jimmyw/energymeter/energymeter.jpg

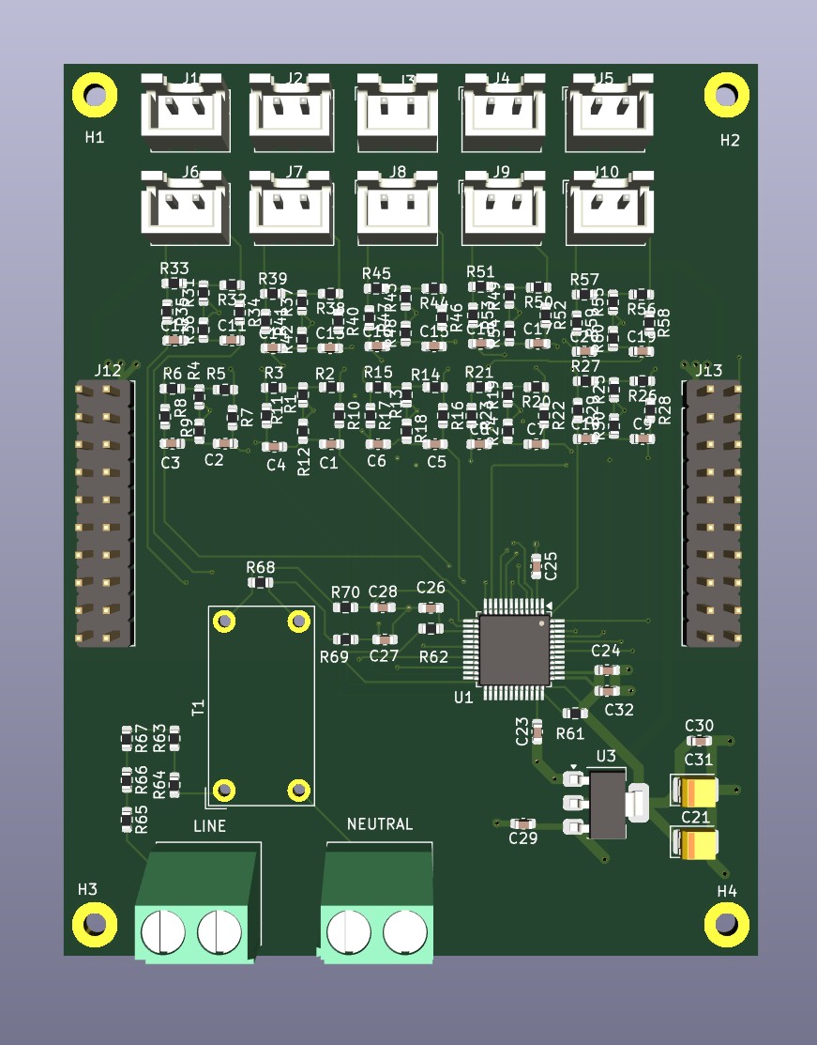
energymeter.jpg
