jimmyw/energymeter/stl/Controller.stl

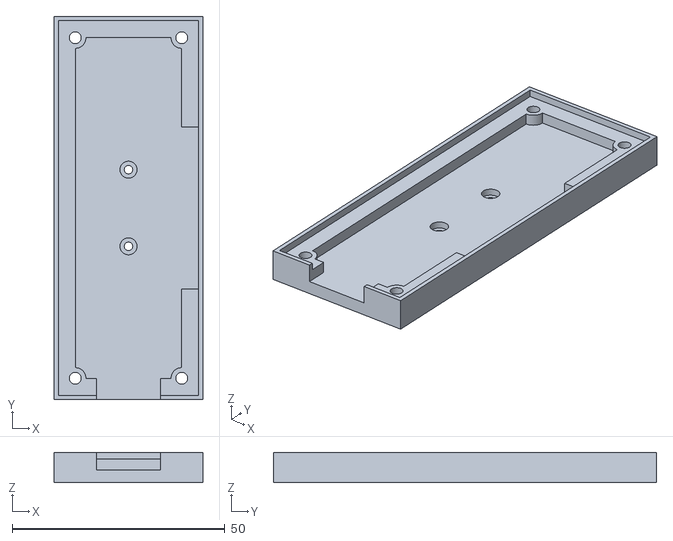
[picture p2: CAD file, 2025-09-19]
stl/Controller.stl
35.0 x 90.0 x 7.10
