jimmyw/energymeter/stl/CoverSmall-small.stl

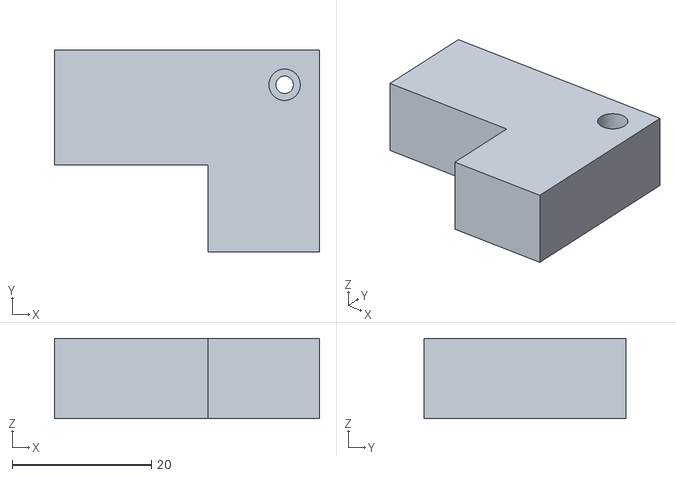
[picture p3: CAD file, 2025-09-19]
stl/CoverSmall-small.stl
38.0 x 29.0 x 11.5
