jimmyw/energymeter/stl/din_rail_mount_G9.stl

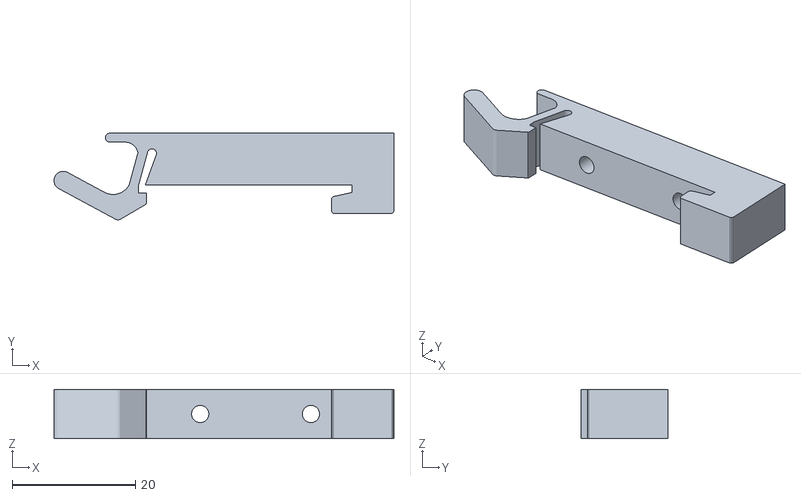
[picture p4: CAD file, 2025-09-19]
stl/din_rail_mount_G9.stl
55.3 x 14.1 x 8.00
