jimmyw/energymeter/stl/EnergyMeter.stl

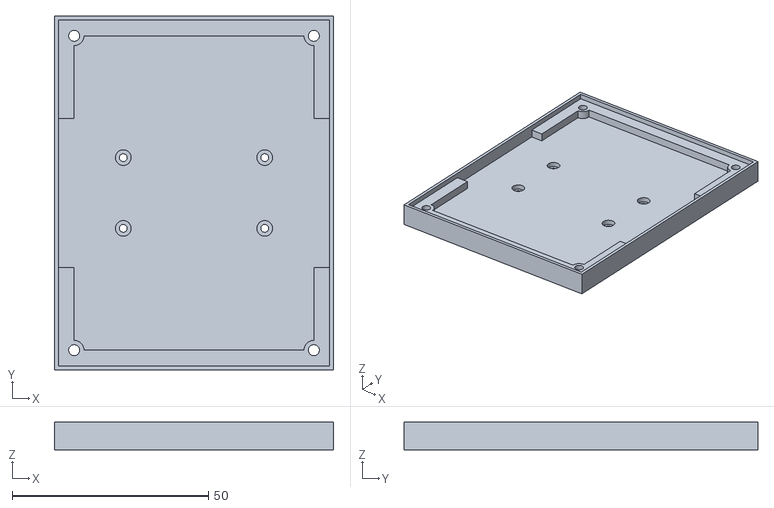
[picture p5: CAD file, 2025-09-19]
stl/EnergyMeter.stl
71.0 x 90.0 x 7.10
