jimmyw/energymeter/stl/controller-lid.stl

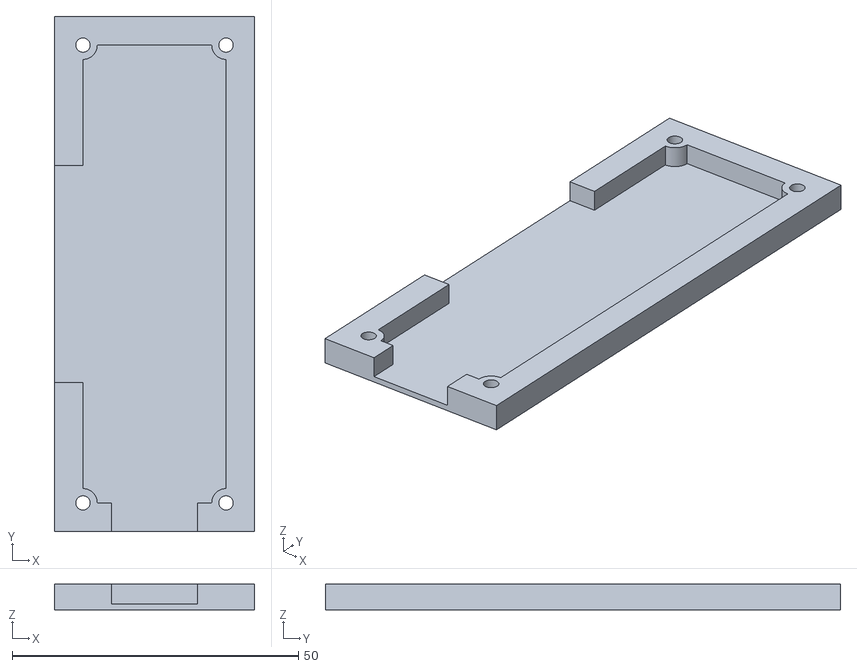
[picture p6: CAD file, 2025-09-19]
stl/controller-lid.stl
35.0 x 90.0 x 4.50
