jimmyw/energymeter/energymeter.kicad_pcb

## KiCad design energymeter.kicad_pcb (2024-08-17)

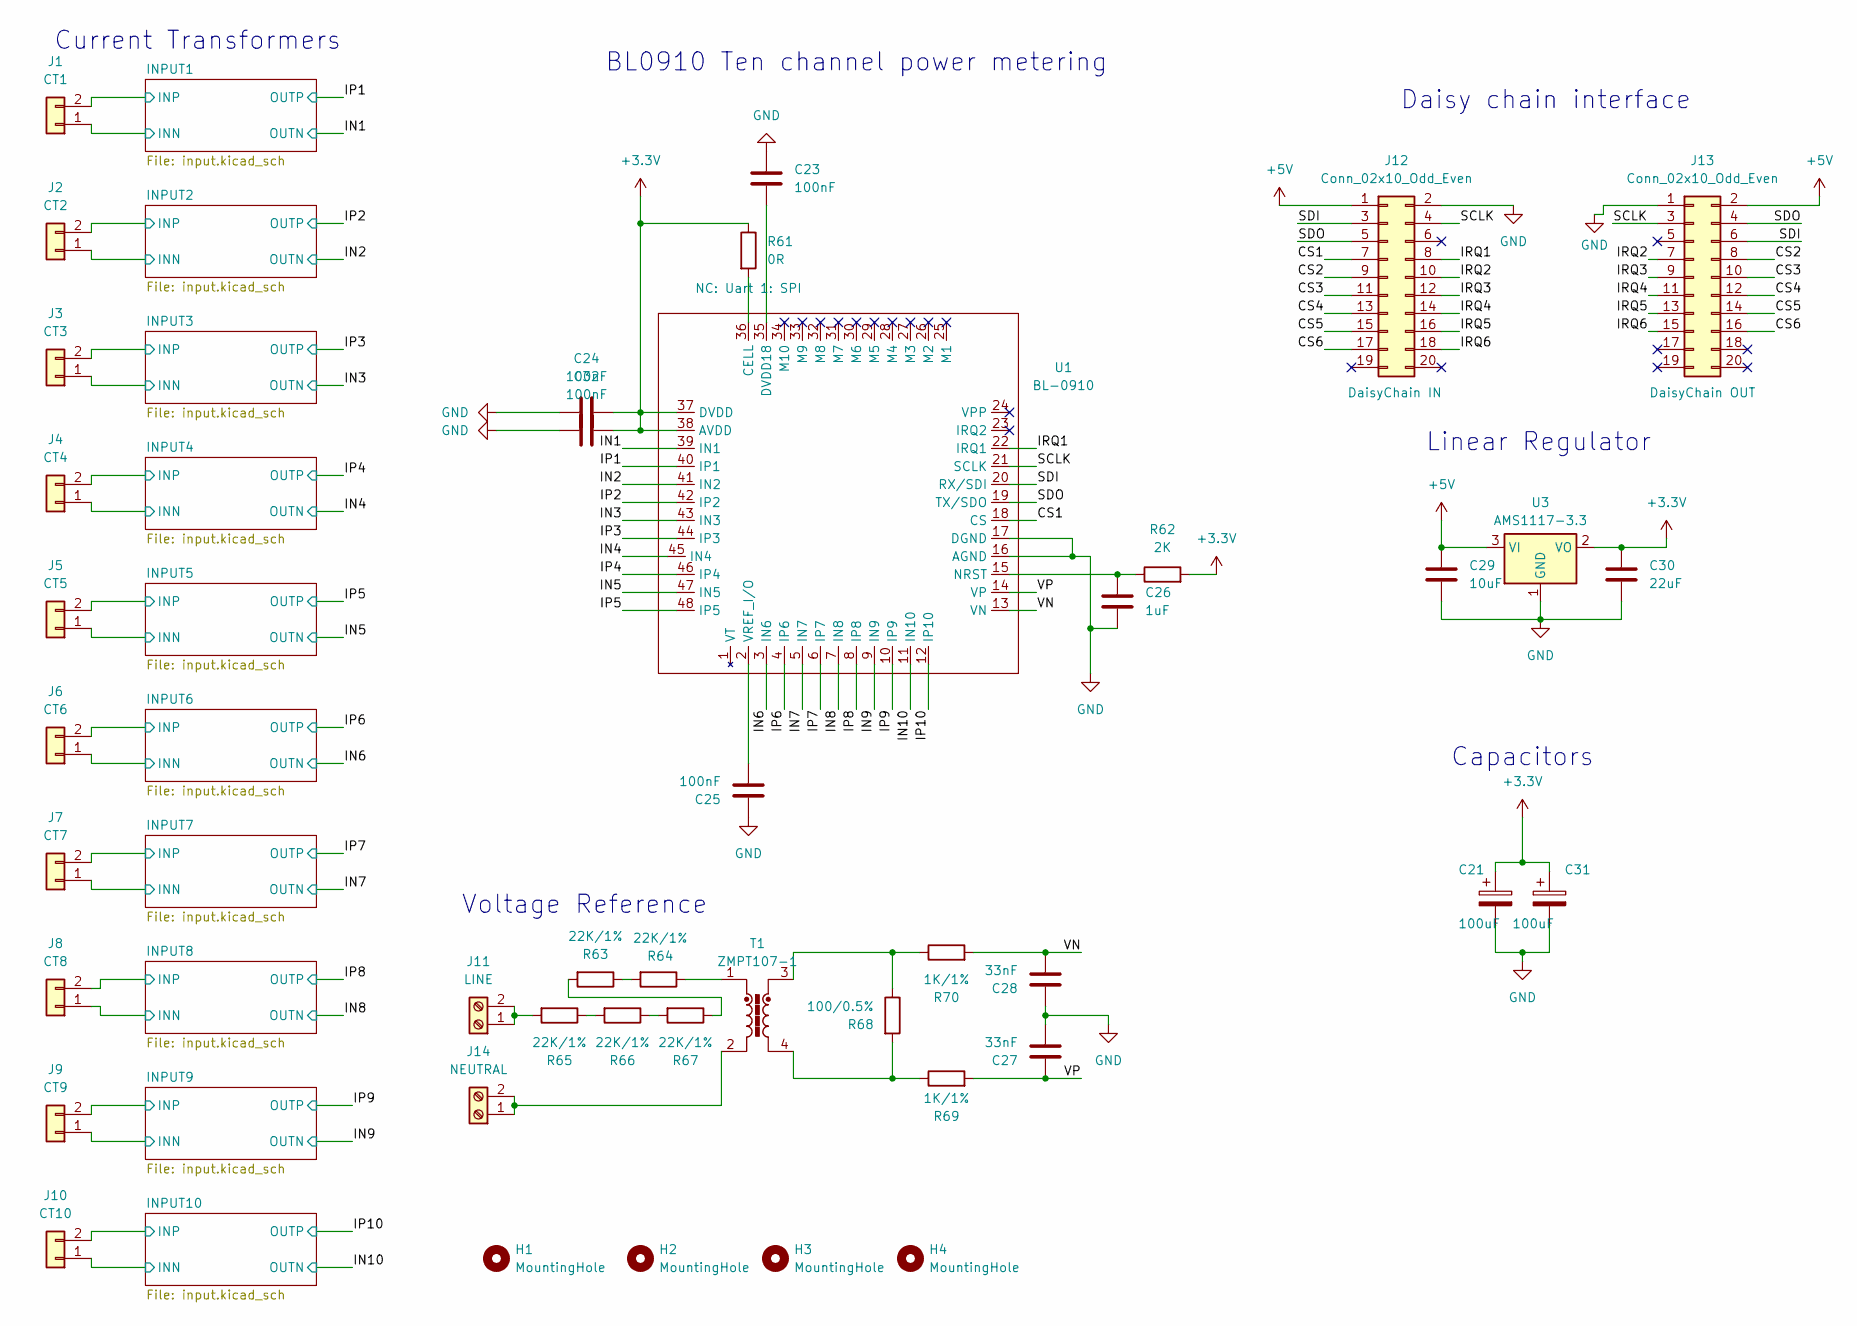
[picture p18: schematic energymeter.kicad_sch]

Parts:
C21, C31: 100uF; CP_EIA-3528-21_Kemet-B; LCSC C16133
C23, C24, C25, C32: 100nF; C_0603_1608Metric; LCSC C14858
C26: 1uF; C_0603_1608Metric; LCSC C15849
C27, C28: 33nF; C_0603_1608Metric; LCSC C21117
C29: 10uF; C_0603_1608Metric; LCSC C14858
C30: 22uF; C_0603_1608Metric; LCSC C59461
H1, H2, H3, H4: MountingHole; MountingHole_2.2mm_M2_Pad
J1: CT1; JST_XH_B2B-XH-A_1x02_P2.50mm_Vertical; LCSC C265283
J2: CT2; JST_XH_B2B-XH-A_1x02_P2.50mm_Vertical; LCSC C265283
J3: CT3; JST_XH_B2B-XH-A_1x02_P2.50mm_Vertical; LCSC C265283
J4: CT4; JST_XH_B2B-XH-A_1x02_P2.50mm_Vertical; LCSC C265283
J5: CT5; JST_XH_B2B-XH-A_1x02_P2.50mm_Vertical; LCSC C265283
J6: CT6; JST_XH_B2B-XH-A_1x02_P2.50mm_Vertical; LCSC C265283
J7: CT7; JST_XH_B2B-XH-A_1x02_P2.50mm_Vertical; LCSC C265283
J8: CT8; JST_XH_B2B-XH-A_1x02_P2.50mm_Vertical; LCSC C265283
J9: CT9; JST_XH_B2B-XH-A_1x02_P2.50mm_Vertical; LCSC C265283
J10: CT10; JST_XH_B2B-XH-A_1x02_P2.50mm_Vertical; LCSC C265283
J11: LINE; TerminalBlock_Phoenix_MKDS-1,5-2_1x02_P5.00mm_Horizontal; LCSC C128027
J12: Conn_02x10_Odd_Even; PinHeader_2x10_P2.54mm_Vertical; LCSC C5454488
J13: Conn_02x10_Odd_Even; PinHeader_2x10_P2.54mm_Vertical; LCSC C239361
J14: NEUTRAL; TerminalBlock_Phoenix_MKDS-1,5-2_1x02_P5.00mm_Horizontal; LCSC C128027
R61: 0R; R_0603_1608Metric; LCSC C21189
R62: 2K; R_0603_1608Metric; LCSC C22975
R63, R64, R65, R66, R67: 22K/1%; R_0603_1608Metric; LCSC C31850
R68: 100/0.5%; R_0603_1608Metric; LCSC C22775
R69, R70: 1K/1%; R_0603_1608Metric; LCSC C21190
T1: ZMPT107-1; LCSC C125191
U1: BL-0910; LQFP-48_7x7mm_P0.5mm; LCSC C2841006
U3: AMS1117-3.3; SOT-223-3_TabPin2; LCSC C6186

Connections:
+3.3V: C21.1, C24.2, C30.1, C31.1, C32.2, R61.1, R62.2, U1.37 (DVDD), U1.38 (AVDD), U3.2 (VO)
+5V: C29.1, J12.1, J13.2, U3.3 (VI)
/CS1: J12.7, U1.18 (CS)
/CS2: J12.9, J13.8
/CS3: J12.11, J13.10
/CS4: J12.13, J13.12
/CS5: J12.15, J13.14
/CS6: J12.17, J13.16
/IN1: U1.39 (IN1); also elsewhere on the board
/IN2: U1.41 (IN2); also elsewhere on the board
/IN3: U1.43 (IN3); also elsewhere on the board
/IN4: U1.45 (IN4); also elsewhere on the board
/IN5: U1.47 (IN5); also elsewhere on the board
/IN6: U1.3 (IN6); also elsewhere on the board
/IN7: U1.5 (IN7); also elsewhere on the board
/IN8: U1.7 (IN8); also elsewhere on the board
/IN9: U1.9 (IN9); also elsewhere on the board
/IN10: U1.11 (IN10); also elsewhere on the board
/INPUT1/INN: J1.1; also elsewhere on the board
/INPUT1/INP: J1.2; also elsewhere on the board
/INPUT2/INN: J2.1; also elsewhere on the board
/INPUT2/INP: J2.2; also elsewhere on the board
/INPUT3/INN: J3.1; also elsewhere on the board
/INPUT3/INP: J3.2; also elsewhere on the board
/INPUT4/INN: J4.1; also elsewhere on the board
/INPUT4/INP: J4.2; also elsewhere on the board
/INPUT5/INN: J5.1; also elsewhere on the board
/INPUT5/INP: J5.2; also elsewhere on the board
/INPUT6/INN: J6.1; also elsewhere on the board
/INPUT6/INP: J6.2; also elsewhere on the board
/INPUT7/INN: J7.1; also elsewhere on the board
/INPUT7/INP: J7.2; also elsewhere on the board
/INPUT8/INN: J8.1; also elsewhere on the board
/INPUT8/INP: J8.2; also elsewhere on the board
/INPUT9/INN: J9.1; also elsewhere on the board
/INPUT9/INP: J9.2; also elsewhere on the board
/INPUT10/INN: J10.1; also elsewhere on the board
/INPUT10/INP: J10.2; also elsewhere on the board
/IP1: U1.40 (IP1); also elsewhere on the board
/IP2: U1.42 (IP2); also elsewhere on the board
/IP3: U1.44 (IP3); also elsewhere on the board
/IP4: U1.46 (IP4); also elsewhere on the board
/IP5: U1.48 (IP5); also elsewhere on the board
/IP6: U1.4 (IP6); also elsewhere on the board
/IP7: U1.6 (IP7); also elsewhere on the board
/IP8: U1.8 (IP8); also elsewhere on the board
/IP9: U1.10 (IP9); also elsewhere on the board
/IP10: U1.12 (IP10); also elsewhere on the board
/IRQ1: J12.8, U1.22 (IRQ1)
/IRQ2: J12.10, J13.7
/IRQ3: J12.12, J13.9
/IRQ4: J12.14, J13.11
/IRQ5: J12.16, J13.13
/IRQ6: J12.18, J13.15
/SCLK: J12.4, J13.3, U1.21 (SCLK)
/SDI: J12.3, J13.6, U1.20 (RX/SDI)
/SDO: J12.5, J13.4, U1.19 (TX/SDO)
/VN: C28.2, R70.2, U1.13 (VN)
/VP: C27.1, R69.2, U1.14 (VP)
GND: C21.2, C23.1, C24.1, C25.1, C26.2, C27.2, C28.1, C29.2, C30.2, C31.2, C32.1, J12.2, J13.1, U1.16 (AGND), U1.17 (DGND), U3.1 (GND); also elsewhere on the board
unnamed: J11.1, J11.2, R65.2
unnamed: J14.1, J14.2, T1.2
unnamed: R63.1, R64.2
unnamed: R63.2, R67.1
unnamed: R64.1, T1.1
unnamed: R65.1, R66.2
unnamed: R66.1, R67.2
unnamed: R68.1, R70.1, T1.3
unnamed: R68.2, R69.1, T1.4
unnamed: R61.2, U1.36 (CELL)
unnamed: C23.2, U1.35 (DVDD18)
unnamed: C26.1, R62.1, U1.15 (NRST)
unnamed: C25.2, U1.2 (VREF_I/O)

Notes on the sheet:
Voltage Reference
Capacitors
Daisy chain interface
Linear Regulator
Current Transformers
BL0910 Ten channel power metering

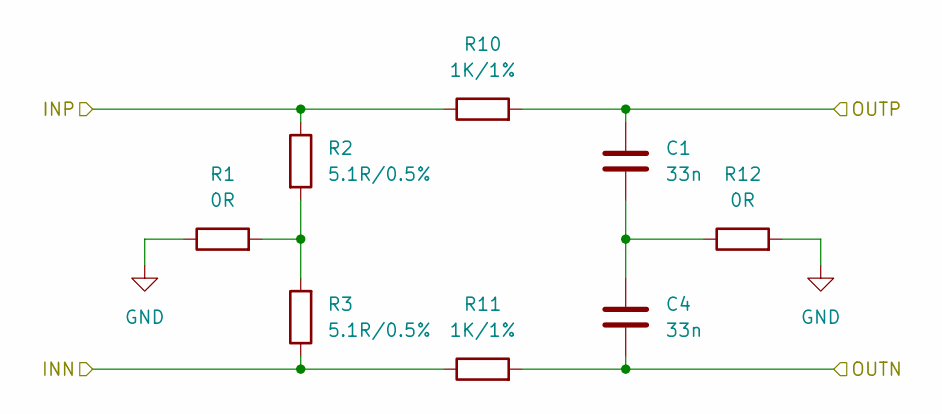
[picture p19: schematic input.kicad_sch]

Parts:
C1, C4: 33n; C_0603_1608Metric; LCSC C21117
R1, R12: 0R; R_0603_1608Metric; LCSC C21189
R2, R3: 5.1R/0.5%; R_0603_1608Metric; LCSC C657209
R10, R11: 1K/1%; R_0603_1608Metric; LCSC C21190

Connections:
/IN2: C4.1, R11.2; also elsewhere on the board
/INPUT2/INN: R3.1, R11.1; also elsewhere on the board
/INPUT2/INP: R2.1, R10.1; also elsewhere on the board
/IP2: C1.2, R10.2; also elsewhere on the board
GND: R1.1, R12.2; also elsewhere on the board
unnamed: C1.1, C4.2, R12.1
unnamed: R1.2, R2.2, R3.2

Parts of its further copies:
C2, C3, C5, C6, C7, C8, C9, C10, C11, C12, C13, C14, C15, C16, C17, C18, C19, C20: 33n; C_0603_1608Metric; LCSC C21117
R4, R9, R13, R18, R19, R24, R25, R30, R31, R36, R37, R42, R43, R48, R49, R54, R55, R60: 0R; R_0603_1608Metric; LCSC C21189
R5, R6, R14, R15, R20, R21, R26, R27, R32, R33, R38, R39, R44, R45, R50, R51, R56, R57: 5.1R/0.5%; R_0603_1608Metric; LCSC C657209
R7, R8, R16, R17, R22, R23, R28, R29, R34, R35, R40, R41, R46, R47, R52, R53, R58, R59: 1K/1%; R_0603_1608Metric; LCSC C21190

Connections of its further copies:
/IN1: C3.1, R8.2; also elsewhere on the board
/IN3: C6.1, R17.2; also elsewhere on the board
/IN4: C8.1, R23.2; also elsewhere on the board
/IN5: C10.1, R29.2; also elsewhere on the board
/IN6: C12.1, R35.2; also elsewhere on the board
/IN7: C14.1, R41.2; also elsewhere on the board
/IN8: C16.1, R47.2; also elsewhere on the board
/IN9: C18.1, R53.2; also elsewhere on the board
/IN10: C20.1, R59.2; also elsewhere on the board
/INPUT1/INN: R6.1, R8.1; also elsewhere on the board
/INPUT1/INP: R5.1, R7.1; also elsewhere on the board
/INPUT3/INN: R15.1, R17.1; also elsewhere on the board
/INPUT3/INP: R14.1, R16.1; also elsewhere on the board
/INPUT4/INN: R21.1, R23.1; also elsewhere on the board
/INPUT4/INP: R20.1, R22.1; also elsewhere on the board
/INPUT5/INN: R27.1, R29.1; also elsewhere on the board
/INPUT5/INP: R26.1, R28.1; also elsewhere on the board
/INPUT6/INN: R33.1, R35.1; also elsewhere on the board
/INPUT6/INP: R32.1, R34.1; also elsewhere on the board
/INPUT7/INN: R39.1, R41.1; also elsewhere on the board
/INPUT7/INP: R38.1, R40.1; also elsewhere on the board
/INPUT8/INN: R45.1, R47.1; also elsewhere on the board
/INPUT8/INP: R44.1, R46.1; also elsewhere on the board
/INPUT9/INN: R51.1, R53.1; also elsewhere on the board
/INPUT9/INP: R50.1, R52.1; also elsewhere on the board
/INPUT10/INN: R57.1, R59.1; also elsewhere on the board
/INPUT10/INP: R56.1, R58.1; also elsewhere on the board
/IP1: C2.2, R7.2; also elsewhere on the board
/IP3: C5.2, R16.2; also elsewhere on the board
/IP4: C7.2, R22.2; also elsewhere on the board
/IP5: C9.2, R28.2; also elsewhere on the board
/IP6: C11.2, R34.2; also elsewhere on the board
/IP7: C13.2, R40.2; also elsewhere on the board
/IP8: C15.2, R46.2; also elsewhere on the board
/IP9: C17.2, R52.2; also elsewhere on the board
/IP10: C19.2, R58.2; also elsewhere on the board
GND: R4.1, R9.2, R13.1, R18.2, R19.1, R24.2, R25.1, R30.2, R31.1, R36.2, R37.1, R42.2, R43.1, R48.2, R49.1, R54.2, R55.1, R60.2; also elsewhere on the board
unnamed: C2.1, C3.2, R9.1
unnamed: C5.1, C6.2, R18.1
unnamed: C7.1, C8.2, R24.1
unnamed: C9.1, C10.2, R30.1
unnamed: C11.1, C12.2, R36.1
unnamed: C13.1, C14.2, R42.1
unnamed: C15.1, C16.2, R48.1
unnamed: C17.1, C18.2, R54.1
unnamed: C19.1, C20.2, R60.1
unnamed: R4.2, R5.2, R6.2
unnamed: R13.2, R14.2, R15.2
unnamed: R19.2, R20.2, R21.2
unnamed: R25.2, R26.2, R27.2
unnamed: R31.2, R32.2, R33.2
unnamed: R37.2, R38.2, R39.2
unnamed: R43.2, R44.2, R45.2
unnamed: R49.2, R50.2, R51.2
unnamed: R55.2, R56.2, R57.2

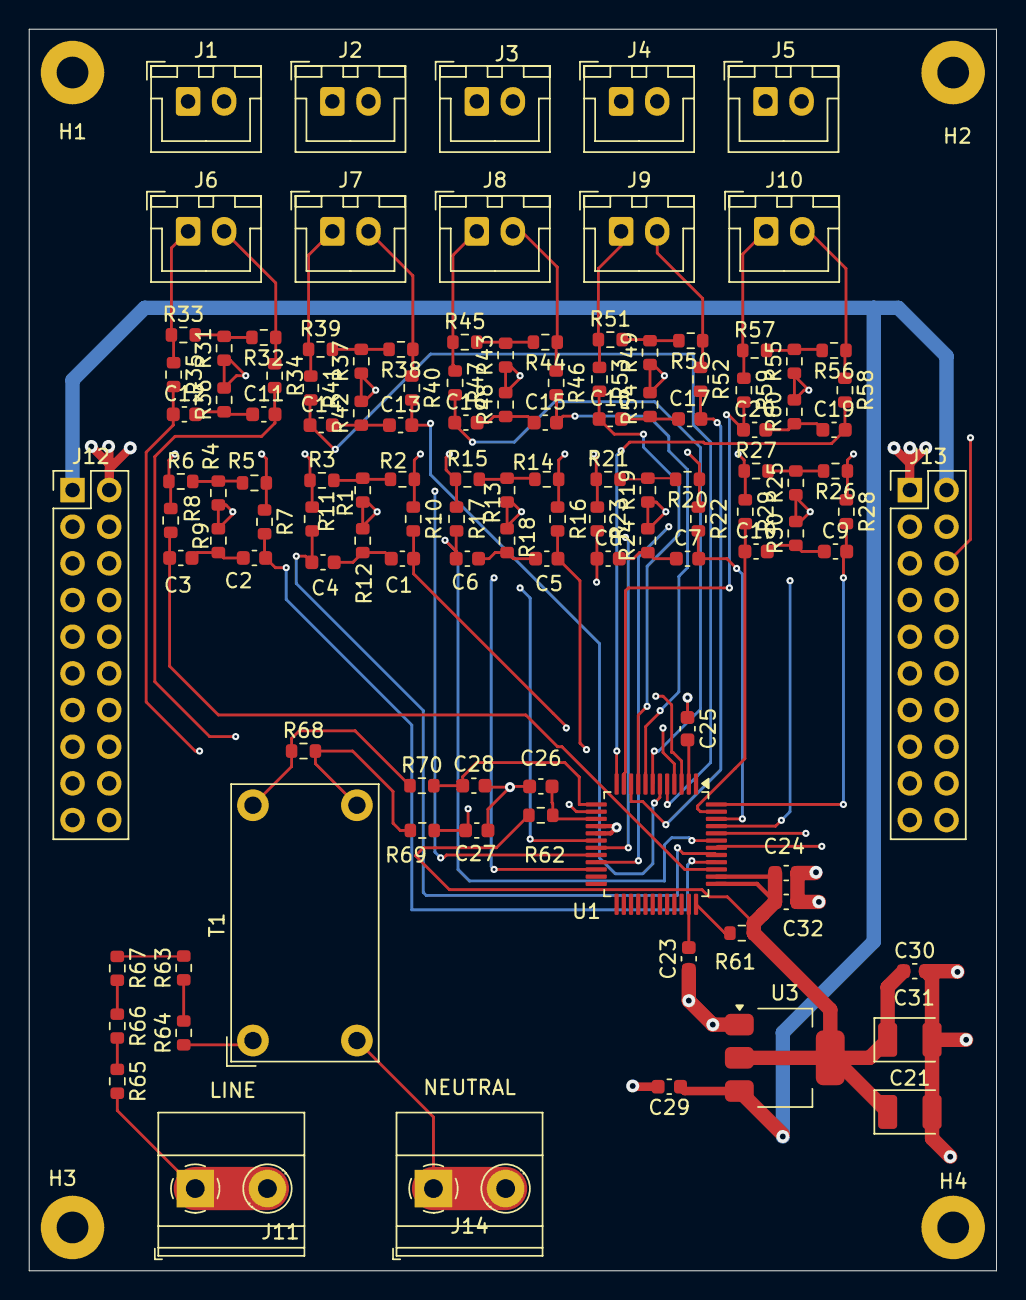
[picture p20: board energymeter.kicad_pcb from above]

Board: 4 copper layers, 67.0 x 86.0 mm, 122 parts (0 on the bottom side), 93 nets.
