jimmyw/energymeter/(commit log)

2024-08-04 Initial add
    [energymeter.kicad_pcb, energymeter.kicad_sch, input.kicad_sch]
2024-08-04 Add schematic and 3d drawing
2024-08-14 Change connector, assign JLCPCB
    [energymeter.kicad_pcb, energymeter.kicad_sch, input.kicad_sch]
2024-08-17 After layout
    [energymeter.kicad_pcb, energymeter.kicad_sch]
2024-08-17 Board cleanup
    [energymeter.kicad_pcb]
2024-08-17 First order
    [bom.csv, designators.csv, energymeter.kicad_pcb, energymeter.kicad_sch, input.kicad_sch, positions.csv]
2024-09-01 Update schematic
2025-09-19 Add stl files for mount
    [Controller.stl, CoverSmall-small.stl, EnergyMeter.stl, controller-lid.stl, din_rail_mount_G9.stl]
